anh311/Home-Sensor/Arduino_Prototyp/README.md

# Home-Sensor Prototype
Prototype of a home sensor using Arduino and the modules I had at home.
