anh311/Home-Sensor/Dokumente/Bauteilliste_Home_Sensor.ods

Name | Beschreibung | Anzahl | Kosten gesamt | Link
ESP32-C3-WROOM-02-N4 | MCU | 1 | 3.28 Euro | https://www.digikey.de/de/products/detail/espressif-systems/ESP32-C3-WROOM-02-N4/14553031
10155435-00011LF | USB TYPE C R/A SMT 16PIN | 1 | 0.78 Euro | https://www.digikey.de/de/products/detail/amphenol-cs-fci/10155435-00011LF/11602060
CP2102N-A02-GQFN28R | USB to UART | 1 | 4.34 Euro | https://www.digikey.de/de/products/detail/silicon-labs/CP2102N-A02-GQFN28R/9863480
2N3904 | TRANS NPN | 2 | 0.28 Euro | https://www.digikey.de/de/products/detail/diotec-semiconductor/2N3904/13164701
BME680 | ENSOR GAS/HUM/PRES/TEMP I2C SPI | 1 | 8.65 Euro | https://www.digikey.de/de/products/detail/bosch-sensortec/BME680/7401317
ULN2003A | MOTOR Driver | 1 | 0.43 Euro | https://www.digikey.de/de/products/detail/stmicroelectronics/ULN2003A/599603
1825910-6 | SWITCH TACTILE | 4 | 044 Euro | https://www.digikey.de/de/products/detail/te-connectivity-alcoswitch-switches/1825910-6/1632536
B5B-XH-A | CONN HEADER VERT 5POS 2.5MM | 1 | 0.17 Euro | https://www.digikey.de/de/products/detail/jst-sales-america-inc/B5B-XH-A/1530483
AMS1117-3.3 SOT-223 | LDO | 1 | 0.1 Euro | https://www.digikey.de/de/products/detail/shenzhen-slkormicro-semicon-co-ltd/AMS1117-3-3-SOT-223/21853079
GG0402052R542P | TVS Diode (ESD) | 3 | 0.66 Euro | https://www.digikey.de/de/products/detail/kyocera-avx/GG0402052R542P/6826544
Stick Chip SH1106 | OLED-Bildschirm | 1 | 2.63 Euro | https://www.aliexpress.com/ssr/300000512/BundleDeals2?productIds=1005006514489341:12000037489532763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
