anh311/Home-Sensor/PCB_Design_home/footprints/BME688/BME688.step

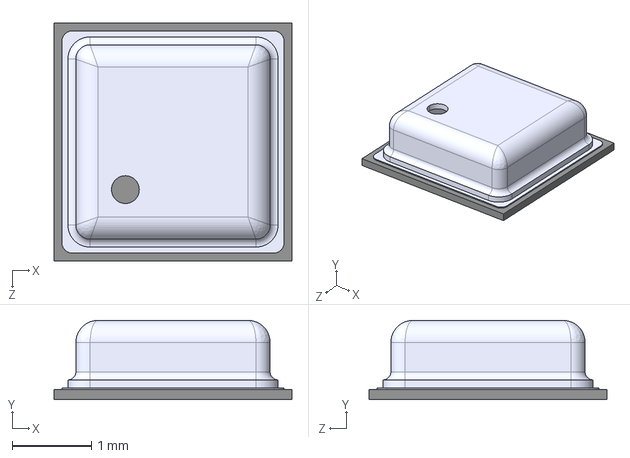
[picture p2: CAD file, 2025-12-27]
PCB_Design_home/footprints/BME688/BME688.step
3.00 x 1.00 x 3.00 mm
