anh311/Home-Sensor/PCB_Design_home/footprints/CP2102N_A02_GQFN28/CP2102N-A02-GQFN28.step

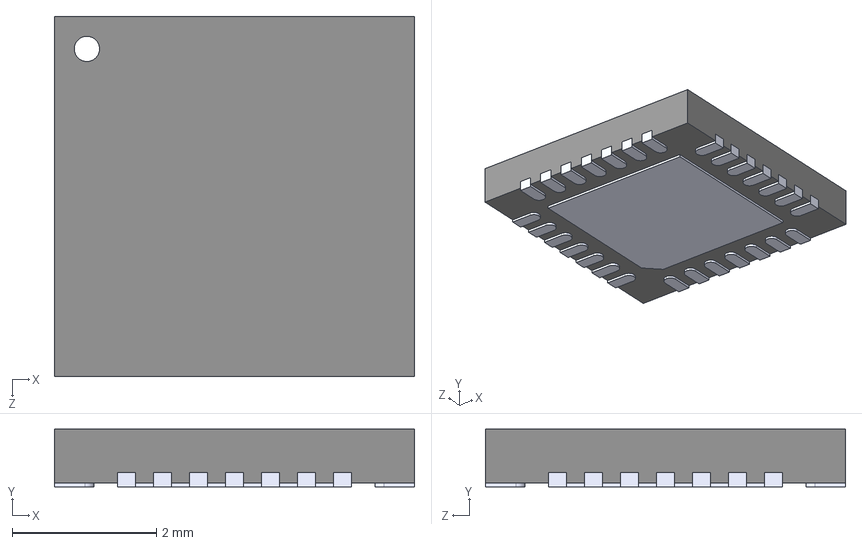
[picture p3: CAD file, 2026-01-06]
PCB_Design_home/footprints/CP2102N_A02_GQFN28/CP2102N-A02-GQFN28.step
5.00 x 0.8 x 5.00 mm
