anh311/Home-Sensor/PCB_Design_home/footprints/USB_connector/10155435-00011LF.step

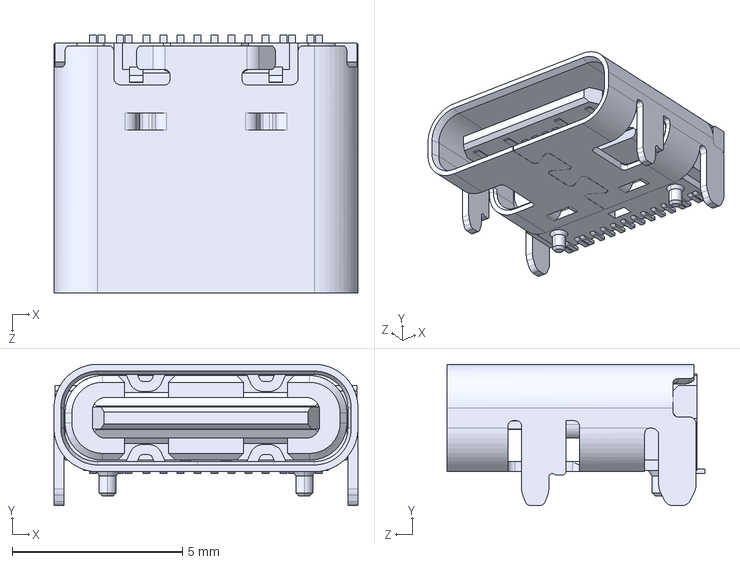
[picture p4: CAD file, 2026-01-06]
PCB_Design_home/footprints/USB_connector/10155435-00011LF.step
8.94 x 4.16 x 7.60 mm
