anh311/Home-Sensor/PCB_Design_home/home/home.kicad_pcb

## KiCad design PCB_Design_home/home/home.kicad_pcb (2026-02-24)

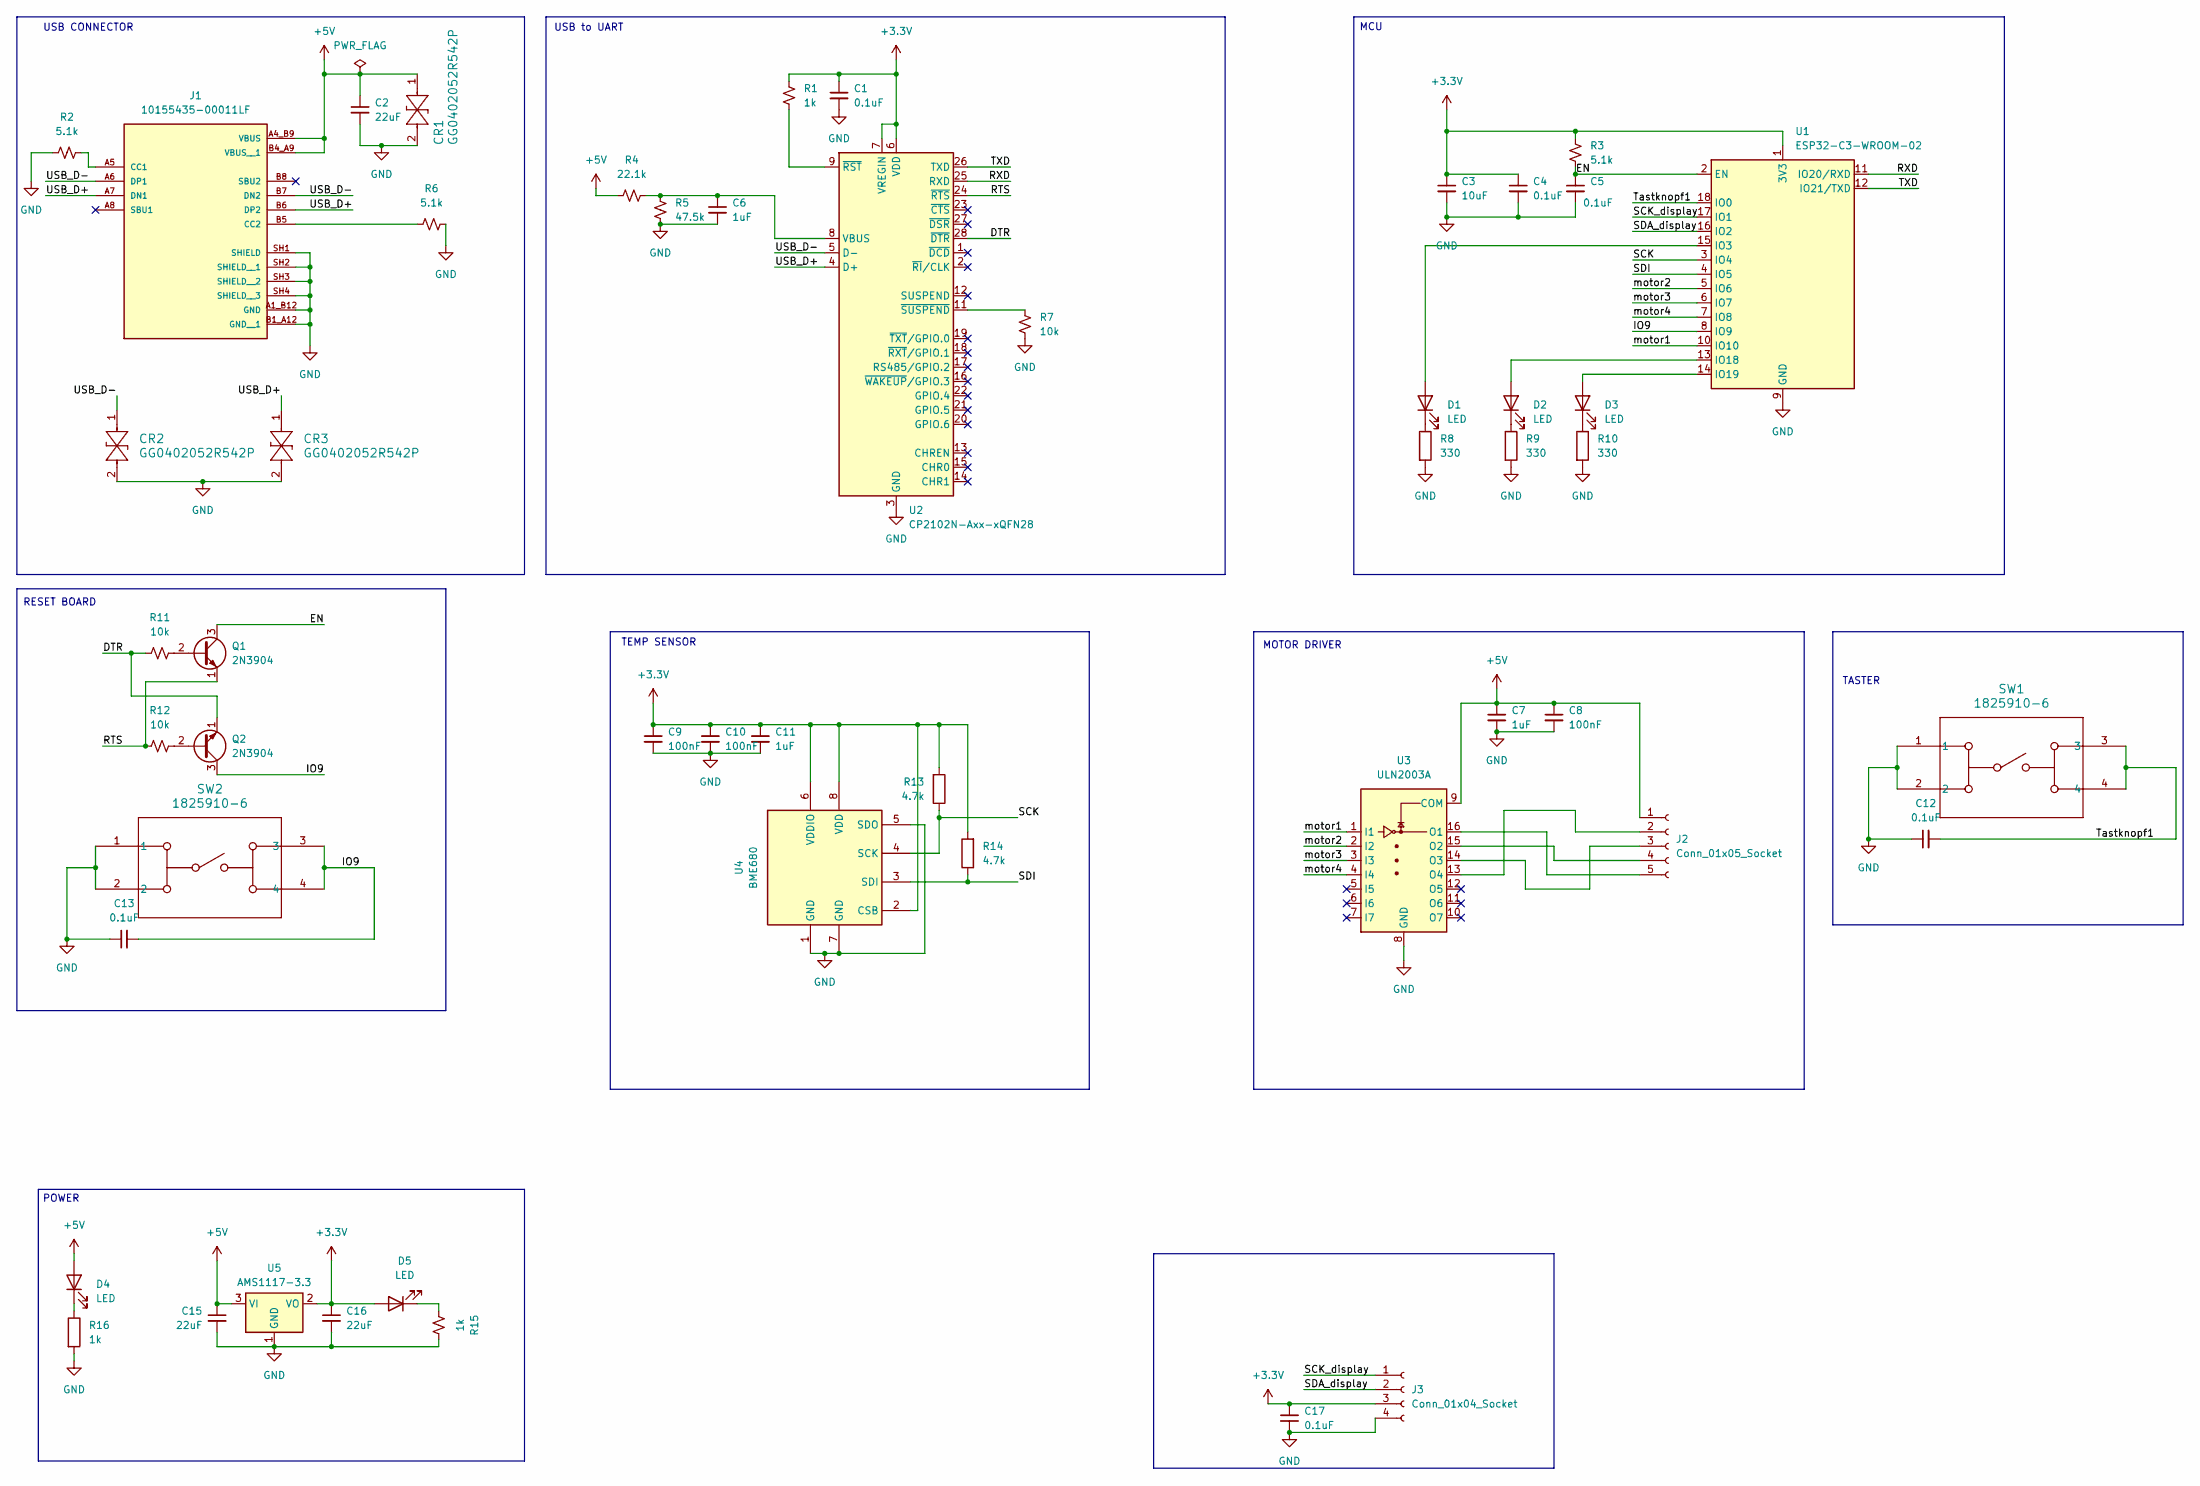
[picture p5: schematic home.kicad_sch, Homesensor_Prototyp_v0]

Parts:
C1, C4, C5, C12, C13, C17: 0.1uF; C_0603_1608Metric_Pad1.08x0.95mm_HandSolder
C2, C15, C16: 22uF; C_0603_1608Metric_Pad1.08x0.95mm_HandSolder
C3: 10uF; C_0603_1608Metric_Pad1.08x0.95mm_HandSolder
C6, C7, C11: 1uF; C_0603_1608Metric_Pad1.08x0.95mm_HandSolder
C8, C9, C10: 100nF; C_0603_1608Metric_Pad1.08x0.95mm_HandSolder
CR1, CR2, CR3: GG0402052R542P; TVS_GG0402_KAV
D1, D2, D3, D4, D5: LED; LED_0603_1608Metric_Pad1.05x0.95mm_HandSolder
J1: 10155435-00011LF; AMPHENOL_10155435-00011LF; PARTREV C
J2: Conn_01x05_Socket; PinSocket_1x05_P2.54mm_Vertical
J3: Conn_01x04_Socket; PinSocket_1x04_P2.54mm_Vertical
Q1, Q2: 2N3904; TO-92_Inline
R1, R15, R16: 1k; R_0603_1608Metric_Pad0.98x0.95mm_HandSolder
R2, R3, R6: 5.1k; R_0603_1608Metric_Pad0.98x0.95mm_HandSolder
R4: 22.1k; R_0603_1608Metric_Pad0.98x0.95mm_HandSolder
R5: 47.5k; R_0603_1608Metric_Pad0.98x0.95mm_HandSolder
R7, R11, R12: 10k; R_0603_1608Metric_Pad0.98x0.95mm_HandSolder
R8, R9, R10: 330; R_0603_1608Metric_Pad0.98x0.95mm_HandSolder
R13, R14: 4.7k; R_0603_1608Metric_Pad0.98x0.95mm_HandSolder
SW1, SW2: 1825910-6; SW4_1825910-B_TEC
U1: ESP32-C3-WROOM-02
U2: CP2102N-Axx-xQFN28; QFN50P500X500X80-29N
U3: ULN2003A; DIP-16_STM
U4: BME680; Bosch_LGA-8_3x3mm_P0.8mm_ClockwisePinNumbering
U5: AMS1117-3.3; SOT-223-3_TabPin2

Connections:
+3.3V: C1.1, C3.1, C4.1, C9.1, C10.1, C11.1, C16.1, C17.1, D5.2 (A), J3.3, R1.2, R3.2, R13.2, R14.2, U1.1 (3V3), U2.6 (VDD), U2.7 (VREGIN), U4.2 (CSB), U4.6 (VDDIO), U4.8 (VDD), U5.2 (VO)
+5V: C2.1, C7.1, C8.1, C15.1, CR1.1, D4.2 (A), J1.A4_B9 (VBUS), J1.B4_A9 (VBUS__1), J2.1, R4.2, U3.9 (COM), U5.3 (VI)
/DTR: Q2.1 (E), R11.2, U2.28 (~DTR)
/EN: C5.1, Q1.3 (C), R3.1, U1.2 (EN)
/IO9: C13.2, Q2.3 (C), SW2.3, SW2.4, U1.8 (IO9)
/RTS: Q1.1 (E), R12.1, U2.24 (~RTS)
/RXD: U1.11 (IO20/RXD), U2.25 (RXD)
/SCK: R13.1, U1.3 (IO4), U4.4 (SCK)
/SCK_display: J3.1, U1.17 (IO1)
/SDA_display: J3.2, U1.16 (IO2)
/SDI: R14.1, U1.4 (IO5), U4.3 (SDI)
/TXD: U1.12 (IO21/TXD), U2.26 (TXD)
/Tastknopf1: C12.2, SW1.3, SW1.4, U1.18 (IO0)
/USB_D+: CR3.1, J1.A7 (DN1), J1.B6 (DP2), U2.4 (D+)
/USB_D-: CR2.1, J1.A6 (DP1), J1.B7 (DN2), U2.5 (D-)
/motor1: U1.10 (IO10), U3.1 (I1)
/motor2: U1.5 (IO6), U3.2 (I2)
/motor3: U1.6 (IO7), U3.3 (I3)
/motor4: U1.7 (IO8), U3.4 (I4)
GND: C1.2, C2.2, C3.2, C4.2, C5.2, C6.2, C7.2, C8.2, C9.2, C10.2, C11.2, C12.1, C13.1, C15.2, C16.2, C17.2, CR1.2, CR2.2, CR3.2, J1.A1_B12 (GND), J1.B1_A12 (GND__1), J1.SH1 (SHIELD), J1.SH2 (SHIELD__1), J1.SH3 (SHIELD__2), J1.SH4 (SHIELD__3), J3.4, R2.2, R5.1, R6.1, R7.1, R8.2, R9.2, R10.2, R15.1, R16.2, SW1.1, SW1.2, SW2.1, SW2.2, U1.9 (GND), U1.19 (GND), U2.3 (GND), U2.29 (GND), U3.8 (GND), U4.1 (GND), U4.5 (SDO), U4.7 (GND), U5.1 (GND)
unnamed: D1.2 (A), U1.15 (IO3)
unnamed: D1.1 (K), R8.1
unnamed: D2.2 (A), U1.13 (IO18)
unnamed: D2.1 (K), R9.1
unnamed: D3.2 (A), U1.14 (IO19)
unnamed: D3.1 (K), R10.1
unnamed: D4.1 (K), R16.1
unnamed: D5.1 (K), R15.2
unnamed: J1.A5 (CC1), R2.1
unnamed: J1.B5 (CC2), R6.2
unnamed: J2.2, U3.13 (O4)
unnamed: J2.3, U3.14 (O3)
unnamed: J2.4, U3.15 (O2)
unnamed: J2.5, U3.16 (O1)
unnamed: Q1.2 (B), R11.1
unnamed: Q2.2 (B), R12.2
unnamed: C6.1, R4.1, R5.2, U2.8 (VBUS)
unnamed: R1.1, U2.9 (~RST)
unnamed: R7.2, U2.11 (~SUSPEND)

Notes on the sheet:
POWER
USB to UART
MOTOR DRIVER
TASTER
RESET BOARD
TEMP SENSOR
USB CONNECTOR
MCU

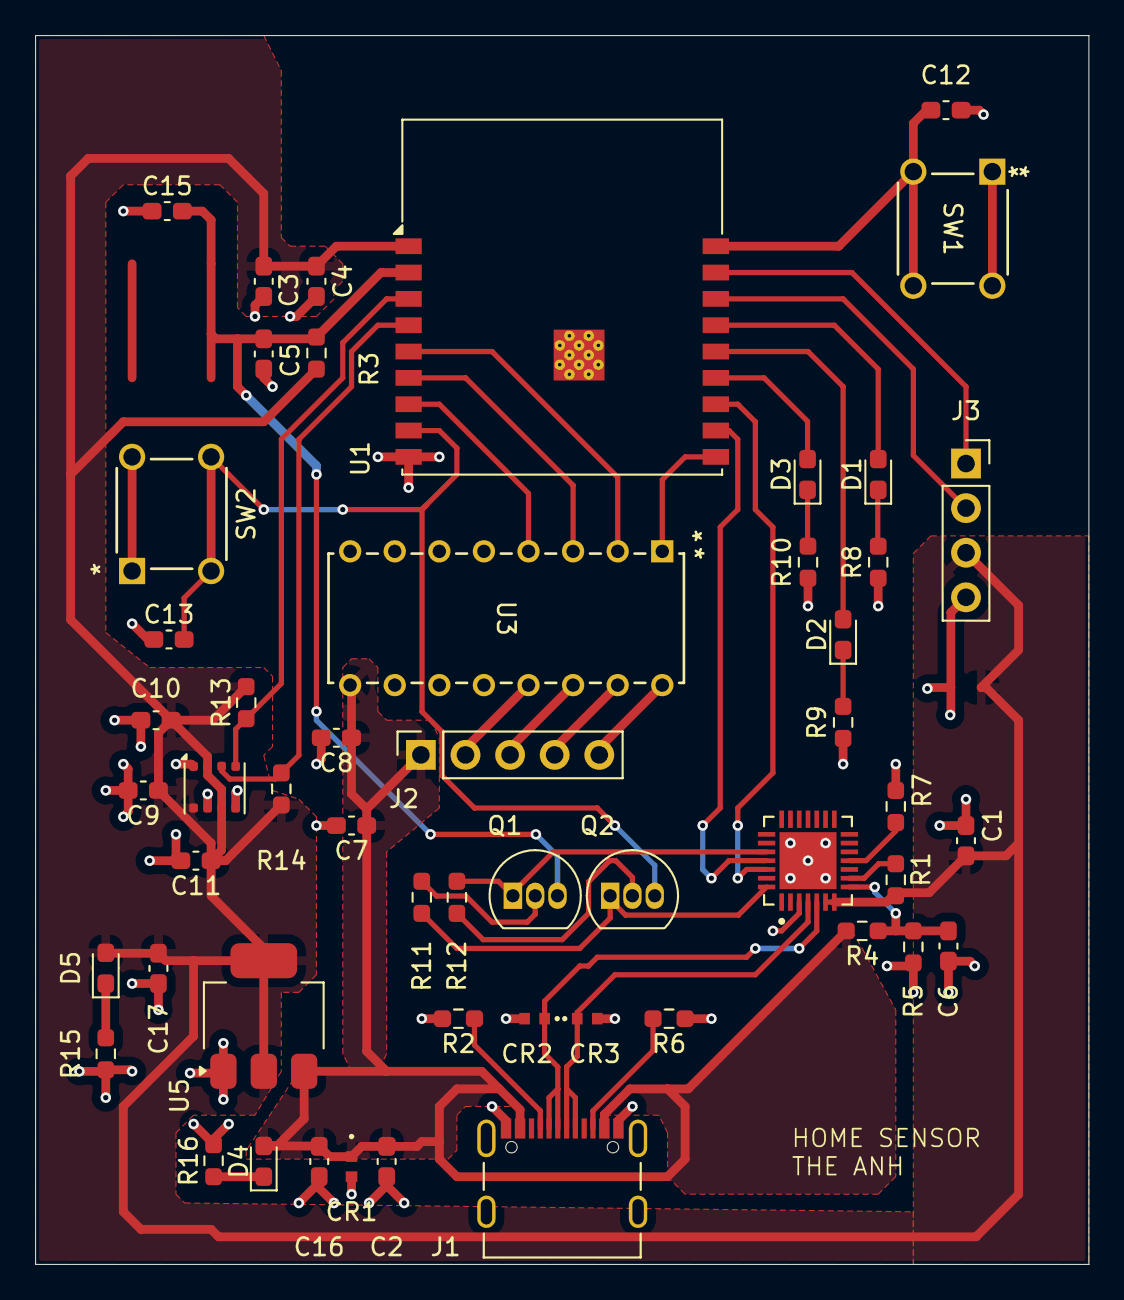
[picture p6: board home.kicad_pcb from above]

Board: 2 copper layers, 60.0 x 70.0 mm, 52 parts (0 on the bottom side), 39 nets.
