anh311/Home-Sensor/Home_Sensor _test/README.md

# ESP32-C3 WROOM-02 Custom Board Hardware Bring-up

troubleshooting steps and hardware corrections required to run an ESP32-C3-WROOM-02 module on custom PCB

## Hardware Corrections 

the following hardware issues were identified and corrected:

- UART TX/RX Swap: The communication lines between the USB-to-UART bridge and the ESP32-C3 (GPIO 20 & 21) were originally swapped.
- Missing GPIO 8 Pull-up: GPIO 8 is a strapping pin for the ESP32-C3 was floating6
- changed C14 for 1k Ohm 

Test 1
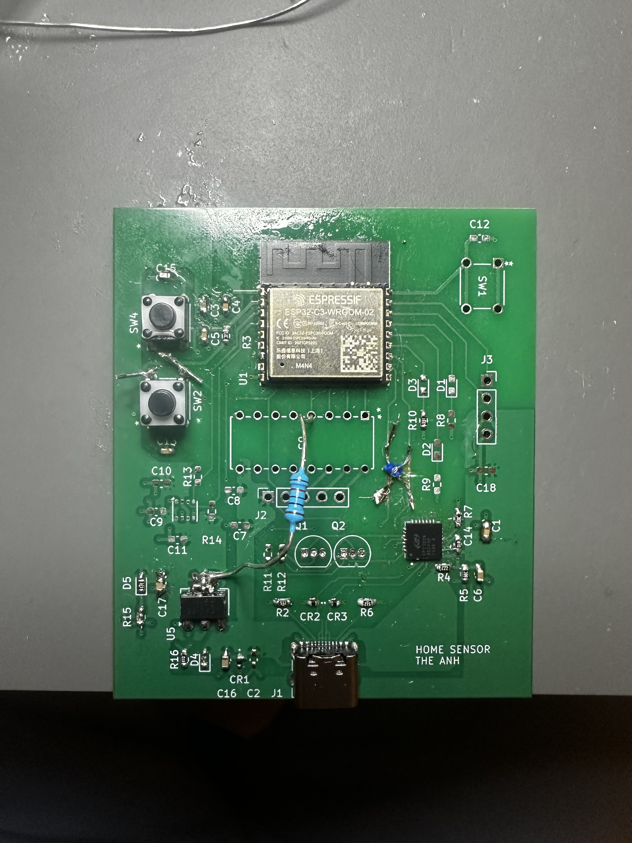
[picture p7: Home_Sensor _test/Test1.jpeg]
Test1


Test 2
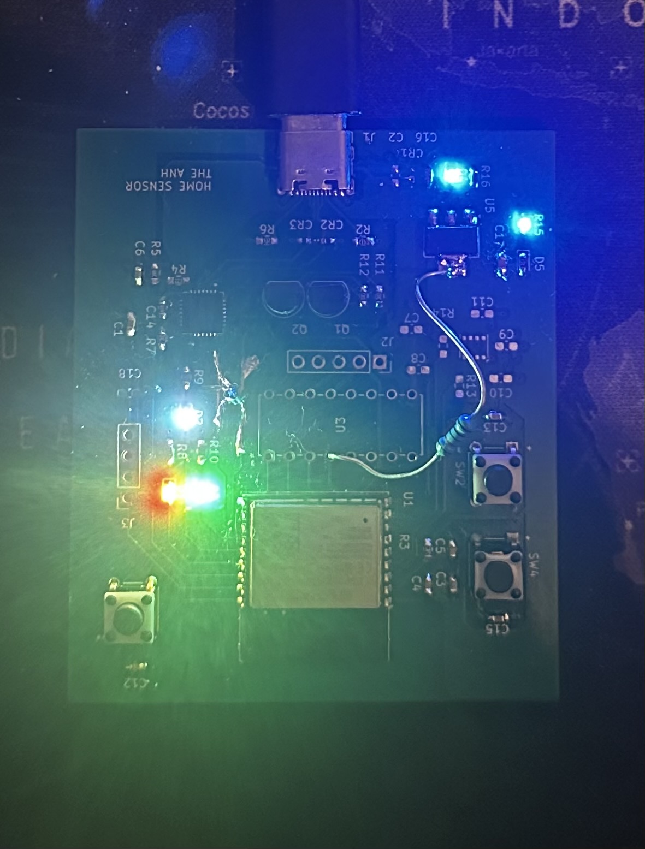
[picture p8: Home_Sensor _test/Test2.jpeg]
Test2


## Notes

- ESP32 IO 19 and IO 18 need swapp in the Symbol (Symbol is wrong)
- ESP 32 C3 only one i2c controller -> put BME860 and Oled on one I2C BUS (one pair of pins  @ ESP32)

- manual flashing works
- RTS DTR logic works
- LED 1-3 works
- Switch works
- Oled Works
- BME680 works
