anh311/Home-Sensor/(commit log)

2025-12-27 Erster Commit meines HomeSensor-Projekts
    [BME688.step, ESP32-S3-MINI-1-N8.step, home.kicad_pcb, home.kicad_sch]
2026-01-13 Update Display
    [home.kicad_pcb, home.kicad_sch]
2026-01-15 Temporary placement
    [home.kicad_pcb, home.kicad_sch]
2026-02-26 Testing HW#
    [home.kicad_sch]
